DeMarco/DMH-Dual-VCF-Diode-Ladder-Mk2/README.md

# DMH-Dual-VCF-Diode-Ladder-Mk2
Version 2 of my dual Diode Ladder VCF module
