DeMarco/DMH-Dual-VCF-Diode-Ladder-Mk2/Simulations/circuit-20260523-2215.png

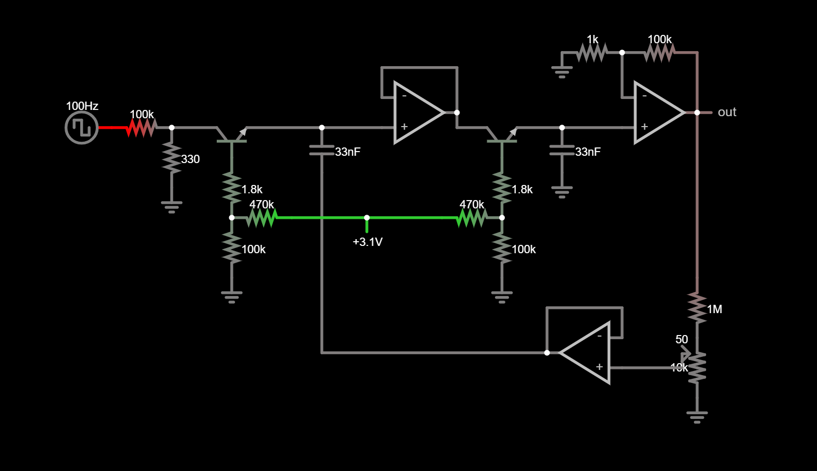
Simulations/circuit-20260523-2215.png
