DeMarco/DMH-Dual-VCF-Diode-Ladder-Mk2/DMH_Dual_VCF_Diode_Ladder_Mk2_PCB_2/DMH_Dual_VCF_Diode_Ladder_Mk2_PCB_2.kicad_pcb

## KiCad design DMH_Dual_VCF_Diode_Ladder_Mk2_PCB_2/DMH_Dual_VCF_Diode_Ladder_Mk2_PCB_2.kicad_pcb (2026-05-23)

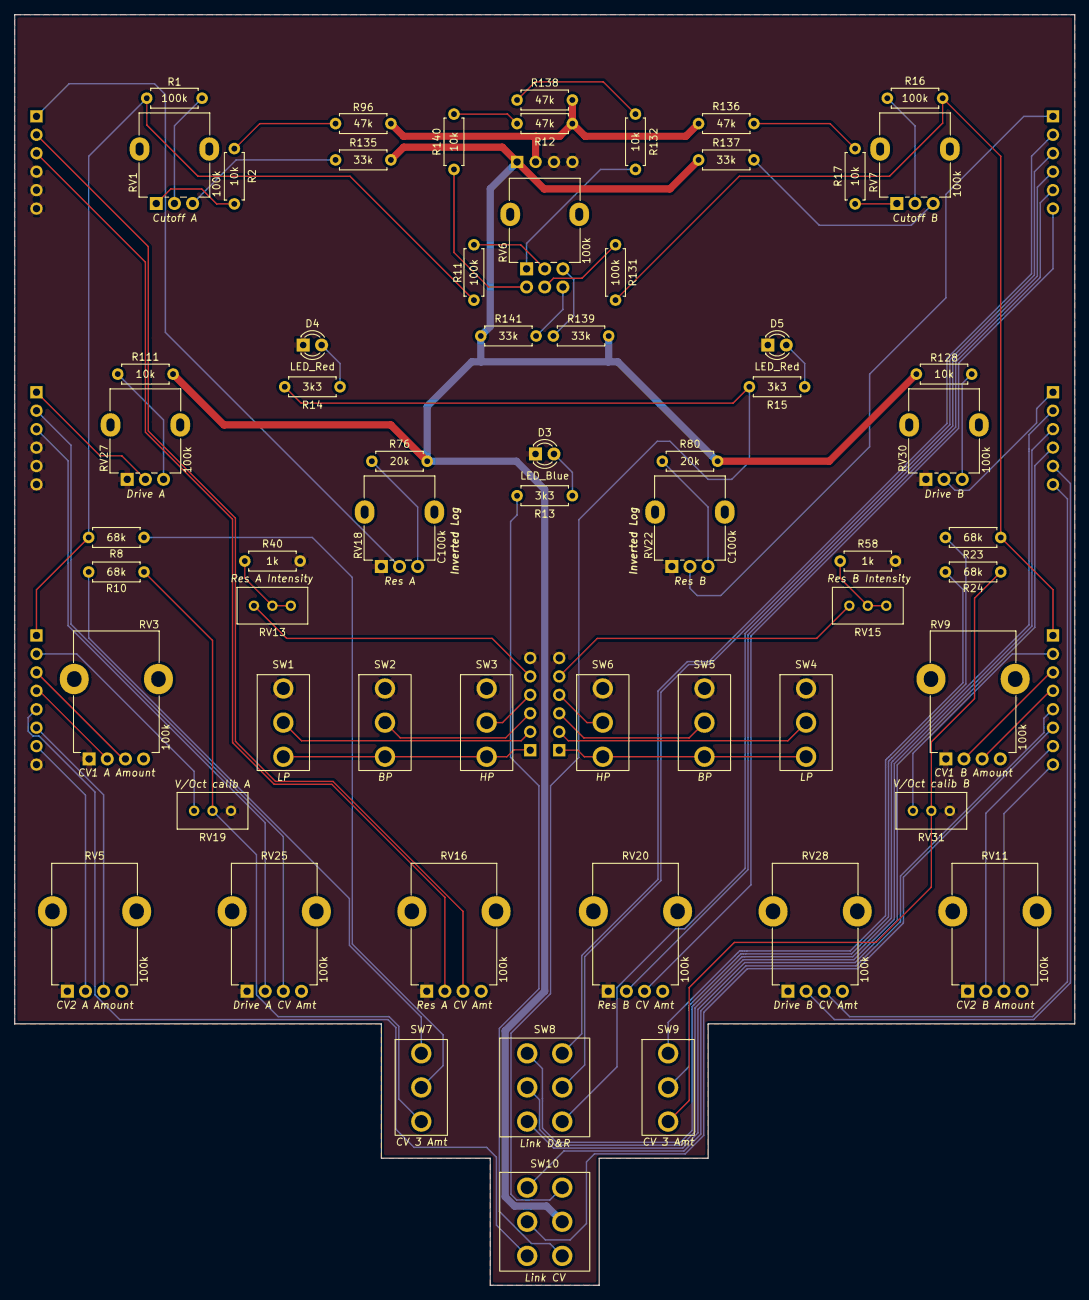
[picture p13: board DMH_Dual_VCF_Diode_Ladder_Mk2_PCB_2.kicad_pcb from above]

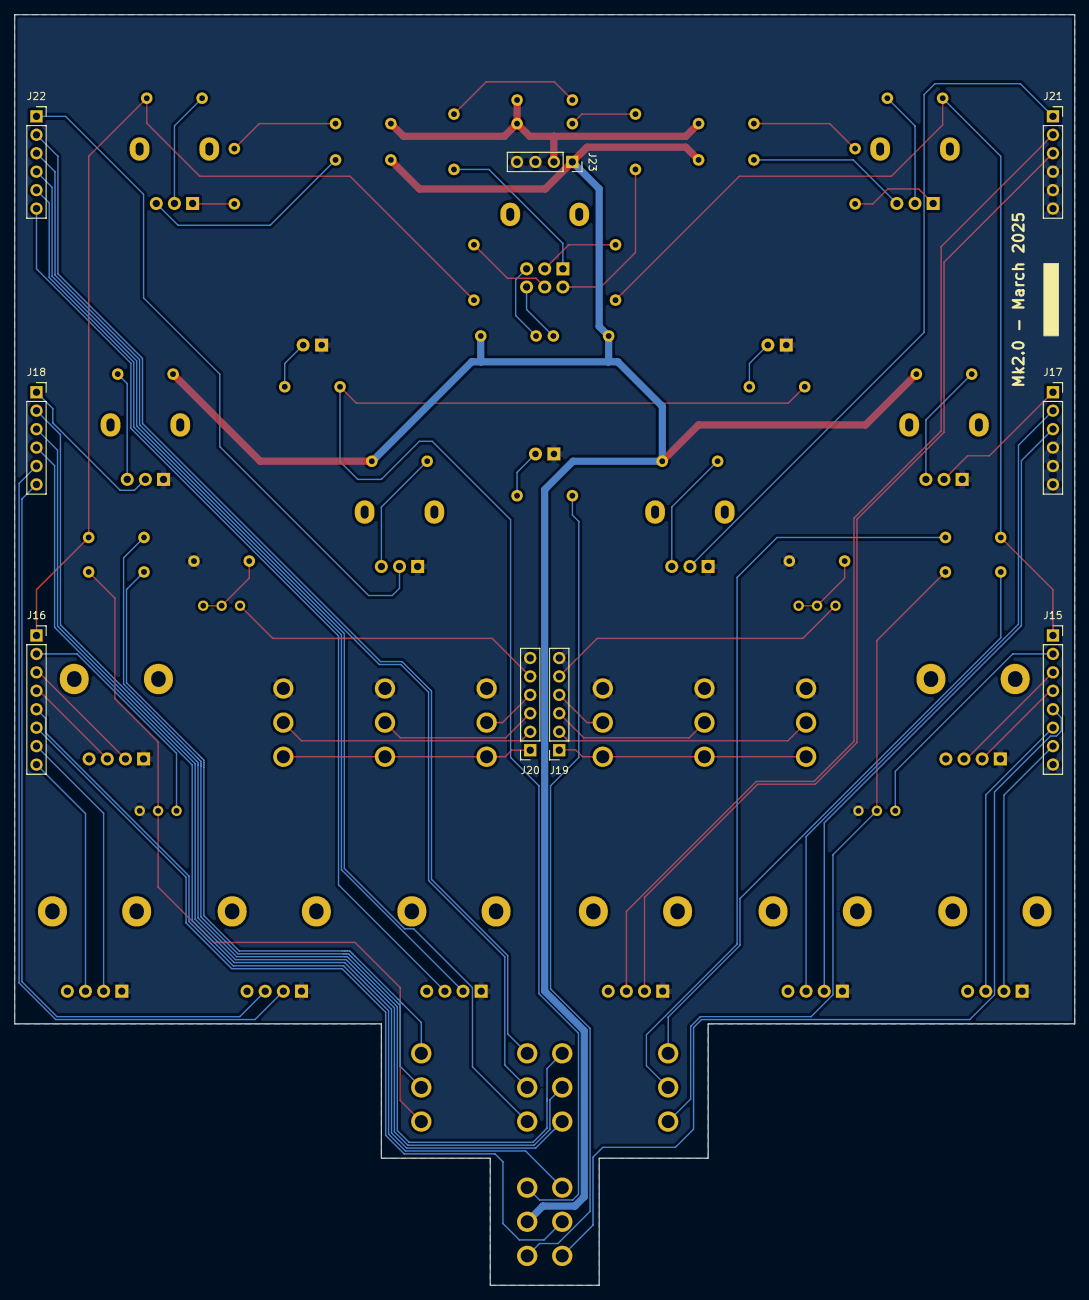
[picture p14: board DMH_Dual_VCF_Diode_Ladder_Mk2_PCB_2.kicad_pcb from below]

Board: 2 copper layers, 146.0 x 175.0 mm, 70 parts (9 on the bottom side), 79 nets.

Parts:
D3: LED_Blue; LED_D3.0mm
D4, D5: LED_Red; LED_D3.0mm
J15, J16: Conn_01x08_PinHeader; PinSocket_1x08_P2.54mm_Vertical
J17, J18, J19, J20, J21, J22: Conn_01x06_PinHeader; PinSocket_1x06_P2.54mm_Vertical
J23: Conn_01x04_PinHeader; PinSocket_1x04_P2.54mm_Vertical
R1, R11, R16, R131: 100k; R_Axial_DIN0207_L6.3mm_D2.5mm_P7.62mm_Horizontal
R2, R17, R111, R128, R132, R140: 10k; R_Axial_DIN0207_L6.3mm_D2.5mm_P7.62mm_Horizontal
R8, R10, R23, R24: 68k; R_Axial_DIN0207_L6.3mm_D2.5mm_P7.62mm_Horizontal
R12, R96, R136, R138: 47k; R_Axial_DIN0207_L6.3mm_D2.5mm_P7.62mm_Horizontal
R13, R14, R15: 3k3; R_Axial_DIN0207_L6.3mm_D2.5mm_P7.62mm_Horizontal
R40, R58: 1k; R_Axial_DIN0207_L6.3mm_D2.5mm_P7.62mm_Horizontal
R76, R80: 20k; R_Axial_DIN0207_L6.3mm_D2.5mm_P7.62mm_Horizontal
R135, R137, R139, R141: 33k; R_Axial_DIN0207_L6.3mm_D2.5mm_P7.62mm_Horizontal
RV1, RV7, RV27, RV30: 100k; Potentiometer_Alpha_RD901F-40-00D_Single_Vertical
RV3, RV5, RV9, RV11, RV16, RV20, RV25, RV28: 100k; Potentiometer_TT_P110KH1
RV6: 100k; Potentiometer_Alpha_RD902F-40-00D_Dual_Vertical
RV13, RV15: 50k; Potentiometer_Bourns_3296W_Vertical
RV18, RV22: C100k; Potentiometer_Alpha_RD901F-40-00D_Single_Vertical
RV19, RV31: 100k; Potentiometer_Bourns_3296W_Vertical
SW1, SW2, SW3, SW4, SW5, SW6: SW_SPDT; Toggle_Switch_TE
SW7, SW9: SW_SPDT_OnOffOn; Toggle_Switch_TE
SW8: SW_DPDT_x2; Toggle_Switch_2_Poles_TE
SW10: SW_DPDT_OnOn; Toggle_Switch_2_Poles_TE

Connections:
+12V: J23.1, R76.2, R80.2, R111.2, R128.2, R135.2, R137.1, R139.2, R141.1, SW10.5 (B)
-12V: J23.2, R12.2, R96.1, R136.1, R138.2
/CV Processing/CV1 A Input: J15.3, RV3.3
/CV Processing/CV1 B Input: J16.4, RV9.3
/CV Processing/CV2 A Input: J15.6, RV5.3
/CV Processing/CV2 B Input: J16.8, RV11.3
/CV Processing/CV A: J15.5, SW10.1 (A)
/CV Processing/CV B: J16.5, SW10.3 (C)
/CV Processing/Link CV Switch: J16.6, SW10.2 (B)
/Drive A/Drive CV: J18.4, SW8.1 (A)
/Drive A/Drive CV Input: J17.2, RV25.3
/Drive B/Drive CV Input: J18.6, RV28.3
/Inputs and Outputs A/Res CV Jack: J21.2, RV16.3
/Inputs and Outputs B/Res CV Jack: J22.6, RV20.3
/Resonance A CV/Res CV: J22.4, SW8.4 (A)
GND: D3.1 (K), D4.1 (K), D5.1 (K), J15.8, J17.4, J17.5, J17.6, J19.6, J20.6, J21.4, J21.5, J21.6, J23.3, J23.4, R40.2, R58.2, RV3.1, RV5.1, RV9.1, RV11.1, RV16.1, RV18.1, RV19.3, RV20.1, RV22.1, RV25.1, RV27.1, RV28.1, RV30.1, RV31.3, SW1.3 (C), SW2.3 (C), SW3.3 (C), SW4.3 (C), SW5.3 (C), SW6.3 (C)
unnamed: D3.2 (A), R13.2
unnamed: D4.2 (A), R14.2
unnamed: D5.2 (A), R15.2
unnamed: J15.1, R1.2, R8.1, R11.2
unnamed: J15.2, RV19.1
unnamed: J15.4, RV3.2
unnamed: J15.7, RV5.2
unnamed: J16.1, R16.2, R23.1, R131.2
unnamed: J16.2, RV31.1
unnamed: J16.3, RV9.2
unnamed: J16.7, RV11.2
unnamed: J17.1, RV27.2
unnamed: J17.3, RV25.2
unnamed: J18.1, RV30.2
unnamed: J18.2, SW8.3 (C)
unnamed: J18.3, SW8.2 (B)
unnamed: J18.5, RV28.2
unnamed: J19.1, SW1.1 (A), SW2.1 (A), SW3.1 (A)
unnamed: J19.2, SW1.2 (B)
unnamed: J19.3, SW2.2 (B)
unnamed: J19.4, SW3.2 (B)
unnamed: J19.5, RV13.1
unnamed: J20.1, SW4.1 (A), SW5.1 (A), SW6.1 (A)
unnamed: J20.2, SW4.2 (B)
unnamed: J20.3, SW5.2 (B)
unnamed: J20.4, SW6.2 (B)
unnamed: J20.5, RV15.1
unnamed: J21.1, RV18.2
unnamed: J21.3, RV16.2
unnamed: J22.1, RV22.2
unnamed: J22.2, SW8.6 (C)
unnamed: J22.3, SW8.5 (B)
unnamed: J22.5, RV20.2
unnamed: R1.1, RV1.2
unnamed: R2.1, RV1.1
unnamed: R2.2, R96.2
unnamed: R11.1, RV6.2
unnamed: R12.1, R140.2
unnamed: R13.1, SW10.4 (A)
unnamed: R14.1, R15.1, SW10.6 (C)
unnamed: R16.1, RV7.2
unnamed: R17.1, RV7.1
unnamed: R40.1, RV13.2, RV13.3
unnamed: R58.1, RV15.2, RV15.3
unnamed: R76.1, RV18.3
unnamed: R80.1, RV22.3
unnamed: R111.1, RV27.3
unnamed: R128.1, RV30.3
unnamed: R131.1, RV6.5
unnamed: R132.1, RV6.1
unnamed: R132.2, R138.1
unnamed: R135.1, RV1.3
unnamed: R17.2, R136.2
unnamed: R137.2, RV7.3
unnamed: R139.1, RV6.3
unnamed: R140.1, RV6.4
unnamed: R141.2, RV6.6
unnamed: R10.2, RV19.2, SW7.1 (A)
unnamed: R8.2, SW7.2 (B)
unnamed: R10.1, SW7.3 (C)
unnamed: R24.2, RV31.2, SW9.1 (A)
unnamed: R23.2, SW9.2 (B)
unnamed: R24.1, SW9.3 (C)
