DeMarco/DMH-Dual-VCF-Diode-Ladder-Mk2/DMH_Dual_VCF_Diode_Ladder_Mk2_PCB_1/DMH_Dual_VCF_Diode_Ladder_Mk2_PCB_1.kicad_pcb

## KiCad design DMH_Dual_VCF_Diode_Ladder_Mk2_PCB_1/DMH_Dual_VCF_Diode_Ladder_Mk2_PCB_1.kicad_pcb (2026-05-23)

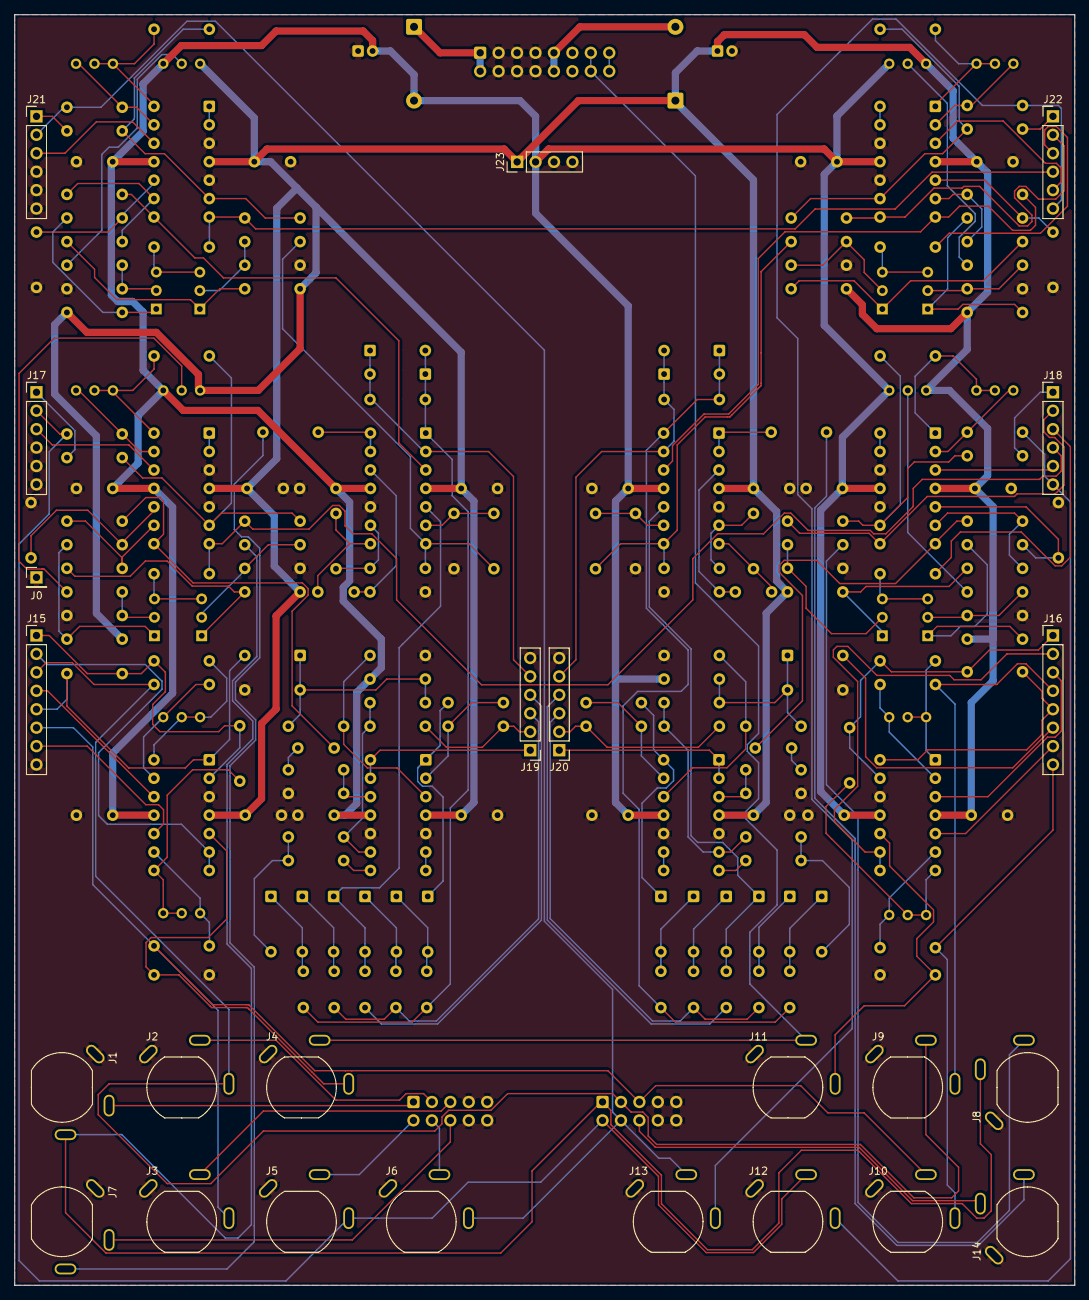
[picture p15: board DMH_Dual_VCF_Diode_Ladder_Mk2_PCB_1.kicad_pcb from above]

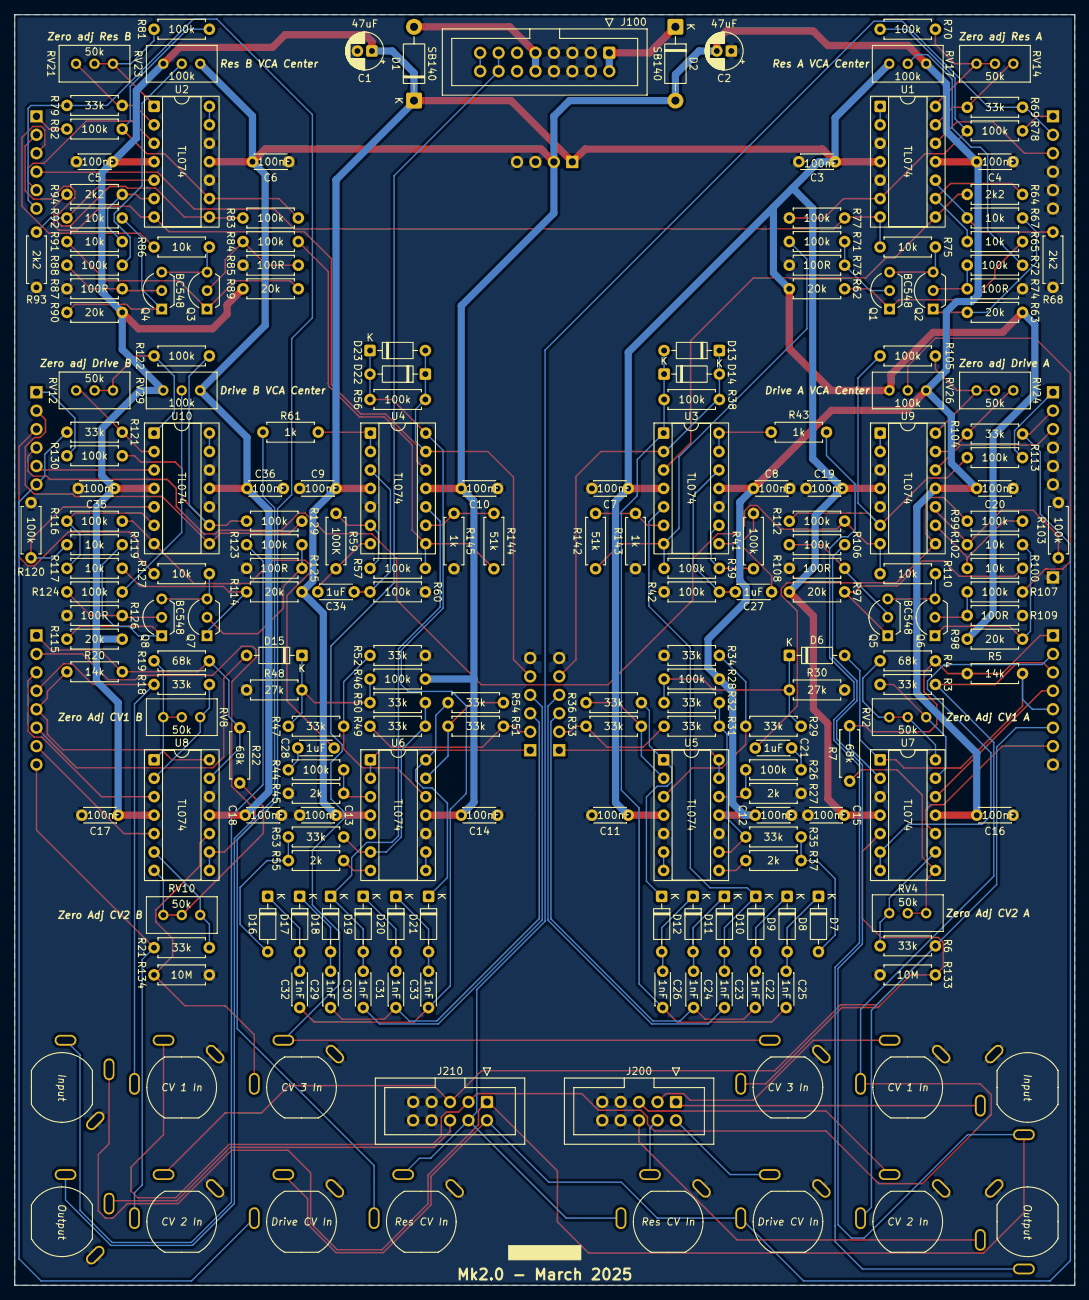
[picture p16: board DMH_Dual_VCF_Diode_Ladder_Mk2_PCB_1.kicad_pcb from below]

Board: 2 copper layers, 146.0 x 175.0 mm, 223 parts (199 on the bottom side), 167 nets.

Parts:
C1, C2: 47uF; CP_Radial_D5.0mm_P2.00mm
C3, C4, C5, C6, C7, C8, C9, C10, C11, C12, C13, C14, C15, C16, C17, C18, C19, C20, C35, C36: 100nF; C_Disc_D4.3mm_W1.9mm_P5.00mm
C21, C27, C28, C34: 1uF; C_Disc_D4.3mm_W1.9mm_P5.00mm
C22, C23, C24, C25, C26, C29, C30, C31, C32, C33: 1nF; C_Disc_D4.3mm_W1.9mm_P5.00mm
D1, D2: SB140; D_DO-41_SOD81_P10.16mm_Horizontal
D6, D7, D8, D9, D10, D11, D12, D13, D14, D15, D16, D17, D18, D19, D20, D21, D22, D23: 1N4148; D_DO-35_SOD27_P7.62mm_Horizontal
J0: Conn_01x01; PinHeader_1x01_P2.54mm_Vertical
J1, J2, J3, J4, J5, J6, J7, J8, J9, J10, J11, J12, J13, J14: TS_Jack_6.35mm_Sw; CUI_MJ-63052A
J15, J16: Conn_01x08_PinHeader; PinHeader_1x08_P2.54mm_Vertical
J17, J18, J19, J20, J21, J22: Conn_01x06_PinHeader; PinHeader_1x06_P2.54mm_Vertical
J23: Conn_01x04_PinHeader; PinHeader_1x04_P2.54mm_Vertical
J100: IDC_02x08; IDC-Header_2x08_P2.54mm_Vertical_Eurorack
J200, J210: IDC_02x05; IDC-Header_2x05_P2.54mm_Vertical_BackBone
Q1, Q2, Q3, Q4, Q5, Q6, Q7, Q8: BC548; TO-92L_Inline_Wide
R3, R6, R18, R21, R29, R31, R32, R33, R34, R35, R36, R47, R49, R50, R51, R52, R53, R54, R69, R79, R104, R121: 33k; R_Axial_DIN0207_L6.3mm_D2.5mm_P7.62mm_Horizontal
R4, R7, R19, R22: 68k; R_Axial_DIN0207_L6.3mm_D2.5mm_P7.62mm_Horizontal
R5, R20: 14k; R_Axial_DIN0207_L6.3mm_D2.5mm_P7.62mm_Horizontal
R26, R28, R38, R39, R41, R42, R44, R46, R56, R57, R60, R70, R71, R72, R77, R78, R81, R82, R83, R84, R88, R99, R103, R105, R106, R107, R112, R113, R116, R120, R122, R123, R124, R129, R130: 100k; R_Axial_DIN0207_L6.3mm_D2.5mm_P7.62mm_Horizontal
R27, R37, R45, R55: 2k; R_Axial_DIN0207_L6.3mm_D2.5mm_P7.62mm_Horizontal
R30, R48: 27k; R_Axial_DIN0207_L6.3mm_D2.5mm_P7.62mm_Horizontal
R43, R61, R143, R145: 1k; R_Axial_DIN0207_L6.3mm_D2.5mm_P7.62mm_Horizontal
R59: 100K; R_Axial_DIN0207_L6.3mm_D2.5mm_P7.62mm_Horizontal
R62, R63, R89, R90, R97, R98, R114, R115: 20k; R_Axial_DIN0207_L6.3mm_D2.5mm_P7.62mm_Horizontal
R64, R68, R93, R94: 2k2; R_Axial_DIN0207_L6.3mm_D2.5mm_P7.62mm_Horizontal
R65, R67, R75, R86, R91, R92, R100, R102, R110, R117, R119, R127: 10k; R_Axial_DIN0207_L6.3mm_D2.5mm_P7.62mm_Horizontal
R73, R74, R85, R87, R108, R109, R125, R126: 100R; R_Axial_DIN0207_L6.3mm_D2.5mm_P7.62mm_Horizontal
R133, R134: 10M; R_Axial_DIN0207_L6.3mm_D2.5mm_P7.62mm_Horizontal
R142, R144: 51k; R_Axial_DIN0207_L6.3mm_D2.5mm_P7.62mm_Horizontal
RV2, RV4, RV8, RV10, RV12, RV14, RV21, RV24: 50k; Potentiometer_Bourns_3296W_Vertical
RV17, RV23, RV26, RV29: 100k; Potentiometer_Bourns_3296W_Vertical
U1, U2, U3, U4, U5, U6, U7, U8, U9, U10: TL074; DIP-14_W7.62mm_Socket

Connections:
+12V: C1.1, C3.1, C5.1, C7.1, C9.1, C11.1, C13.1, C15.1, C17.1, C19.1, C35.1, D1.1 (K), J23.1, R62.2, R63.2, R89.2, R90.2, R97.2, R98.2, R114.2, R115.2, RV17.3, RV23.3, RV26.3, RV29.3, U1.4 (V+), U2.4 (V+), U3.4 (V+), U4.4 (V+), U5.4 (V+), U6.4 (V+), U7.4 (V+), U8.4 (V+), U9.4 (V+), U10.4 (V+)
-12V: C2.2, C4.2, C6.2, C8.2, C10.2, C12.2, C14.2, C16.2, C18.2, C20.2, C36.2, D2.2 (A), J23.2, R28.1, R46.1, RV17.1, RV23.1, RV26.1, RV29.1, U1.11 (V-), U2.11 (V-), U3.11 (V-), U4.11 (V-), U5.11 (V-), U6.11 (V-), U7.11 (V-), U8.11 (V-), U9.11 (V-), U10.11 (V-)
/CV Processing/CV1 A Input: J2.T, J9.TN, J15.3, J210.2, R3.1
/CV Processing/CV1 B Input: J9.T, J16.4, R18.1
/CV Processing/CV2 A Input: J3.T, J10.TN, J15.6, J210.3, R6.1
/CV Processing/CV2 B Input: J10.T, J16.8, R21.1
/CV Processing/CV3 A Input: J4.T, R133.2, U7.5 (+)
/CV Processing/CV3 B Input: J11.T, R134.2, U8.10 (+)
/CV Processing/CV A: D6.2 (A), J15.5, R5.2, U7.1
/CV Processing/CV B: J16.5, R20.2, U8.14
/CV Processing/Link CV Switch: D15.2 (A), J16.6
/Core Circuit A/Input: C21.1, R99.1, U9.8
/Core Circuit A/Output: J7.T, R43.2
/Core Circuit A/Raw Output: R39.1, R71.2, R142.2, U3.7
/Core Circuit A/Res Input: R64.1, U1.8, U3.3 (+)
/Core Circuit B/Input: C28.1, R116.1, U10.7
/Core Circuit B/Output: J14.T, R61.2
/Core Circuit B/Raw Output: R57.1, R84.2, R144.2, U4.8
/Core Circuit B/Res Input: R94.1, U2.7, U4.12 (+)
/Drive A/Drive CV: J18.4, R110.1, R112.2, U9.7
/Drive A/Drive CV Input: J5.T, J12.TN, J17.2, J210.6, R104.1
/Drive A/Input: J1.T, J8.TN, J210.1, R106.2
/Drive B/Drive CV Input: J12.T, J18.6, R121.1
/Drive B/Input: J8.T, R123.2
/Inputs and Outputs A/CV 3 TN: J4.TN, J11.TN, J100.7a, J100.7b
/Inputs and Outputs A/Res CV Jack: J6.T, J13.TN, J21.2, J210.7, R69.1
/Inputs and Outputs B/Res CV Jack: J13.T, J22.6, R79.1
/Power/Bus Gate: J100.8a, J100.8b
/Resonance A CV/Res CV: J22.4, R75.1, R77.2, U1.7
GND: C1.2, C2.1, C3.2, C4.1, C5.2, C6.1, C7.2, C8.1, C9.2, C10.1, C11.2, C12.1, C13.2, C14.1, C15.2, C16.1, C17.2, C18.1, C19.2, C20.1, C35.2, C36.1, J0.1, J1.S, J2.S, J3.S, J4.S, J5.S, J6.S, J7.S, J8.S, J9.S, J10.S, J11.S, J12.S, J13.S, J14.S, J15.8, J17.4, J17.5, J17.6, J19.6, J20.6, J21.4, J21.5, J21.6, J23.3, J23.4, J100.2a, J100.2b, J100.3a, J100.3b, J100.4a, J100.4b, J200.4, J200.5, J200.9, J200.10, J210.4, J210.5, J210.9, J210.10, R27.1, R30.2, R34.1, R42.1, R45.1, R48.2, R52.1, R60.1, R68.2, R73.1, R74.1, R85.1, R87.1, R93.2, R103.2, R108.1, R109.1, R120.2, R125.1, R126.1, R133.1, R134.1, R143.1, R145.1, U1.3 (+), U1.5 (+), U2.10 (+), U2.12 (+), U3.10 (+), U4.5 (+), U5.5 (+), U5.10 (+), U6.5 (+), U6.10 (+), U7.3 (+), U8.12 (+), U9.3 (+), U9.5 (+), U10.10 (+), U10.12 (+)
unnamed: C21.2, R26.1
unnamed: C27.1, R41.2, U3.8
unnamed: C28.2, R44.1
unnamed: C34.1, R59.2, U4.7
unnamed: D1.2 (A), J100.5a, J100.5b
unnamed: D2.1 (K), J100.1a, J100.1b
unnamed: D6.1 (K), R28.2, R29.1, R30.1, R32.1
unnamed: D7.2 (A), R35.2, R37.2
unnamed: C25.1, D7.1 (K), D8.2 (A)
unnamed: C22.2, D8.1 (K), D9.2 (A)
unnamed: C23.2, D9.1 (K), D10.2 (A), U3.5 (+)
unnamed: C24.2, D10.1 (K), D11.2 (A)
unnamed: C26.1, D11.1 (K), D12.2 (A)
unnamed: D12.1 (K), R36.2, U5.1
unnamed: C25.2, C26.2, D13.2 (A), D14.1 (K), R38.1, U3.1
unnamed: D13.1 (K), D14.2 (A), J19.5, R38.2, U3.2 (-)
unnamed: D15.1 (K), R46.2, R47.1, R48.1, R50.1
unnamed: D16.2 (A), R53.2, R55.2
unnamed: C32.1, D16.1 (K), D17.2 (A)
unnamed: C29.2, D17.1 (K), D18.2 (A)
unnamed: C30.2, D18.1 (K), D19.2 (A), U4.10 (+)
unnamed: C31.2, D19.1 (K), D20.2 (A)
unnamed: C33.1, D20.1 (K), D21.2 (A)
unnamed: D21.1 (K), R54.2, U6.14
unnamed: C32.2, C33.2, D22.2 (A), D23.1 (K), R56.1, U4.14
unnamed: D22.1 (K), D23.2 (A), J20.5, R56.2, U4.13 (-)
unnamed: J15.1, R4.2, R5.1, R7.2, U7.2 (-)
unnamed: J15.2, U7.6 (-), U7.7
unnamed: J15.4, U7.12 (+)
unnamed: J15.7, U7.10 (+)
unnamed: J16.1, R19.2, R20.1, R22.2, U8.13 (-)
unnamed: J16.2, U8.8, U8.9 (-)
unnamed: J16.3, U8.3 (+)
unnamed: J16.7, U8.5 (+)
unnamed: J17.1, R113.1
unnamed: J17.3, U9.12 (+)
unnamed: J18.1, R130.1
unnamed: J18.2, R129.2, U10.8
unnamed: J18.3, R127.1
unnamed: J18.5, U10.3 (+)
unnamed: J19.1, U5.13 (-), U5.14
unnamed: J19.2, R31.1, R33.1
unnamed: C22.1, C24.1, J19.3
unnamed: C23.1, J19.4
unnamed: J20.1, U6.1, U6.2 (-)
unnamed: J20.2, R49.1, R51.1
unnamed: C29.1, C31.1, J20.3
unnamed: C30.1, J20.4
unnamed: J21.1, R78.1
unnamed: J21.3, U1.12 (+)
unnamed: J22.1, R82.1
unnamed: J22.2, R83.2, U2.8
unnamed: J22.3, R86.1
unnamed: J22.5, U2.3 (+)
unnamed: J1.TN, J200.1
unnamed: J2.TN, J200.2
unnamed: J3.TN, J200.3
unnamed: J5.TN, J200.6
unnamed: J6.TN, J200.7
unnamed: J7.TN, J200.8
unnamed: J14.TN, J210.8
unnamed: Q1.2 (B), R71.1, R73.2
unnamed: Q1.1 (C), R62.1, R65.2
unnamed: Q1.3 (E), Q2.3 (E), R75.2
unnamed: Q2.2 (B), R72.2, R74.2
unnamed: Q2.1 (C), R63.1, R67.2
unnamed: Q3.2 (B), R84.1, R85.2
unnamed: Q3.1 (C), R89.1, R91.2
unnamed: Q3.3 (E), Q4.3 (E), R86.2
unnamed: Q4.2 (B), R87.2, R88.2
unnamed: Q4.1 (C), R90.1, R92.2
unnamed: Q5.2 (B), R106.1, R108.2
unnamed: Q5.1 (C), R97.1, R100.2
unnamed: Q5.3 (E), Q6.3 (E), R110.2
unnamed: Q6.2 (B), R107.2, R109.2
unnamed: Q6.1 (C), R98.1, R102.2
unnamed: Q7.2 (B), R123.1, R125.2
unnamed: Q7.1 (C), R114.1, R117.2
unnamed: Q7.3 (E), Q8.3 (E), R127.2
unnamed: Q8.2 (B), R124.2, R126.2
unnamed: Q8.1 (C), R115.1, R119.2
unnamed: R4.1, RV2.2, RV2.3, U7.14
unnamed: R7.1, RV4.2, RV4.3, U7.8
unnamed: R19.1, RV8.2, RV8.3, U8.1
unnamed: R22.1, RV10.2, RV10.3, U8.7
unnamed: R37.1, U5.8
unnamed: R55.1, U6.7
unnamed: R70.1, RV14.2, RV14.3, U1.14
unnamed: R72.1, RV17.2
unnamed: R81.1, RV21.2, RV21.3, U2.1
unnamed: R88.1, RV23.2
unnamed: R105.1, RV24.2, RV24.3, U9.14
unnamed: R107.1, RV26.2
unnamed: R122.1, RV12.2, RV12.3, U10.1
unnamed: R124.1, RV29.2
unnamed: U1.1, U1.2 (-)
unnamed: R70.2, R77.1, R78.2, U1.6 (-)
unnamed: R67.1, R68.1, U1.10 (+)
unnamed: R64.2, R65.1, U1.9 (-)
unnamed: R69.2, RV14.1, U1.13 (-)
unnamed: R79.2, RV21.1, U2.2 (-)
unnamed: R92.1, R93.1, U2.5 (+)
unnamed: R91.1, R94.2, U2.6 (-)
unnamed: R81.2, R82.2, R83.1, U2.9 (-)
unnamed: U2.13 (-), U2.14
unnamed: R142.1, R143.2, U3.6 (-)
unnamed: R39.2, R41.1, U3.9 (-)
unnamed: C27.2, R42.2, U3.12 (+)
unnamed: R43.1, U3.13 (-), U3.14
unnamed: C34.2, R60.2, U4.3 (+)
unnamed: R61.1, U4.1, U4.2 (-)
unnamed: R57.2, R59.1, U4.6 (-)
unnamed: R144.1, R145.2, U4.9 (-)
unnamed: R29.2, R34.2, U5.3 (+)
unnamed: R33.2, R36.1, U5.2 (-)
unnamed: U5.6 (-), U5.7
unnamed: R31.2, R32.2, R35.1, U5.9 (-)
unnamed: R26.2, R27.2, U5.12 (+)
unnamed: R44.2, R45.2, U6.3 (+)
unnamed: R49.2, R50.2, R53.1, U6.6 (-)
unnamed: U6.8, U6.9 (-)
unnamed: R47.2, R52.2, U6.12 (+)
unnamed: R51.2, R54.1, U6.13 (-)
unnamed: R6.2, RV4.1, U7.9 (-)
unnamed: R3.2, RV2.1, U7.13 (-)
unnamed: R18.2, RV8.1, U8.2 (-)
unnamed: R21.2, RV10.1, U8.6 (-)
unnamed: U9.1, U9.2 (-)
unnamed: R105.2, R112.1, R113.2, U9.6 (-)
unnamed: R102.1, R103.1, U9.10 (+)
unnamed: R99.2, R100.1, U9.9 (-)
unnamed: R104.2, RV24.1, U9.13 (-)
unnamed: R121.2, RV12.1, U10.2 (-)
unnamed: R119.1, R120.1, U10.5 (+)
unnamed: R116.2, R117.1, U10.6 (-)
unnamed: R122.2, R129.1, R130.2, U10.9 (-)
unnamed: U10.13 (-), U10.14
