DeMarco/DMH-Dual-VCF-Diode-Ladder-Mk2/(commit log)

2025-01-14 Created KiCad projects
    [Bridge.kicad_sch, CV_Processing.kicad_sch, Core_Circuit.kicad_sch, Core_Circuit_A.kicad_sch, Core_Circuit_B.kicad_sch, DMH_Dual_VCF_Diode_Ladder_Mk2_PANEL.kicad_pcb, DMH_Dual_VCF_Diode_Ladder_Mk2_PANEL.kicad_sch, DMH_Dual_VCF_Diode_Ladder_Mk2_PCB_1.kicad_pcb]
2025-01-15 Added CV3 and Drive CV to Panel
    [DMH_Dual_VCF_Diode_Ladder_Mk2_PANEL.kicad_pcb, DMH_Dual_VCF_Diode_Ladder_Mk2_PANEL.kicad_sch]
2025-01-15 Added CV3 and Drive CV to I/O pages
    [CV_Processing.kicad_sch, DMH_Dual_VCF_Diode_Ladder_Mk2_PCB_1.kicad_sch, Inputs_and_Outputs_A.kicad_sch, Inputs_and_Outputs_B.kicad_sch]
2025-01-18 Added board-to-board pins to schematic
    [CV_Processing.kicad_sch, Core_Circuit_A.kicad_sch, Core_Circuit_B.kicad_sch, DMH_Dual_VCF_Diode_Ladder_Mk2_PCB_1.kicad_sch, Inputs_and_Outputs_A.kicad_sch, Inputs_and_Outputs_B.kicad_sch, Resonance_A_CV.kicad_sch, Resonance_B_CV.kicad_sch]
2025-01-19 Created Drive CV circuits
    [Core_Circuit_A.kicad_sch, DMH_Dual_VCF_Diode_Ladder_Mk2_PCB_1.kicad_sch, Drive_A.kicad_sch, Drive_A_CV.kicad_sch, Drive_B.kicad_sch, Resonance_B_CV.kicad_sch]
2025-01-19 Added inter-board pins to all circuits
    [CV_Processing.kicad_sch, Core_Circuit_A.kicad_sch, Core_Circuit_B.kicad_sch, DMH_Dual_VCF_Diode_Ladder_Mk2_PCB_1.kicad_sch, Drive_A.kicad_sch, Drive_B.kicad_sch, Inputs_and_Outputs_A.kicad_sch, Inputs_and_Outputs_B.kicad_sch]
2025-01-20 Connecting main blocks in progress
    [CV_Processing.kicad_sch, Core_Circuit_A.kicad_sch, Core_Circuit_B.kicad_sch, DMH_Dual_VCF_Diode_Ladder_Mk2_PCB_1.kicad_sch, Drive_A.kicad_sch, Drive_B.kicad_sch, Inputs_and_Outputs_A.kicad_sch, Inputs_and_Outputs_B.kicad_sch]
2025-01-20 Connected all hierarchical pins
    [DMH_Dual_VCF_Diode_Ladder_Mk2_PCB_1.kicad_sch]
2025-01-21 Annotating OpAmps in progress
    [Resonance_A_CV.kicad_sch]
2025-01-21 Reannotated OpAmps and cleared errors
    [CV_Processing.kicad_sch, DMH_Dual_VCF_Diode_Ladder_Mk2_PCB_1.kicad_sch, Drive_A.kicad_sch, Drive_B.kicad_sch, Power.kicad_sch, Resonance_A_CV.kicad_sch]
2025-01-22 Set Exclude From Board properties for main PCB
    [CV_Processing.kicad_sch, Core_Circuit_A.kicad_sch, Core_Circuit_B.kicad_sch, Drive_A.kicad_sch, Drive_B.kicad_sch, Inputs_and_Outputs_A.kicad_sch, Inputs_and_Outputs_B.kicad_sch, Power.kicad_sch]
2025-01-22 Corrected pin header footprint assignments
    [CV_Processing.kicad_sch, Core_Circuit_A.kicad_sch, Core_Circuit_B.kicad_sch, Drive_B.kicad_sch, Power.kicad_sch, Resonance_B_CV.kicad_sch]
2025-01-22 Created pots PCB project
    [Bridge.kicad_sch, CV_Processing.kicad_sch, Core_Circuit.kicad_sch, Core_Circuit_A.kicad_sch, Core_Circuit_B.kicad_sch, DMH_Dual_VCF_Diode_Ladder_Mk2_PCB_2.kicad_pcb, DMH_Dual_VCF_Diode_Ladder_Mk2_PCB_2.kicad_sch, Drive_A.kicad_sch]
2025-01-22 Exclude From Board in progress
    [CV_Processing.kicad_sch, Core_Circuit_A.kicad_sch, Core_Circuit_B.kicad_sch, DMH_Dual_VCF_Diode_Ladder_Mk2_PCB_2.kicad_sch, Drive_A.kicad_sch, Inputs_and_Outputs_A.kicad_sch, Inputs_and_Outputs_B.kicad_sch, Power.kicad_sch]
2025-01-22 Complete Exclude From Board on PCB 2
    [CV_Processing.kicad_sch, Core_Circuit_A.kicad_sch, Core_Circuit_B.kicad_sch, Drive_A.kicad_sch, Drive_B.kicad_sch, Power.kicad_sch, Resonance_A_CV.kicad_sch, Resonance_B_CV.kicad_sch]
2025-01-22 Component placement on PCB2 in progress
    [CV_Processing.kicad_sch, DMH_Dual_VCF_Diode_Ladder_Mk2_PCB_2.kicad_pcb]
2025-01-23 pcb 2 routing in progress
    [CV_Processing.kicad_sch, Core_Circuit_B.kicad_sch, DMH_Dual_VCF_Diode_Ladder_Mk2_PCB_2.kicad_pcb, Drive_A.kicad_sch, Drive_B.kicad_sch, Power.kicad_sch, Resonance_A_CV.kicad_sch, Resonance_B_CV.kicad_sch]
2025-01-24 Finished PCB 2
    [DMH_Dual_VCF_Diode_Ladder_Mk2_PCB_2.kicad_pcb, Resonance_B_CV.kicad_sch]
2025-01-25 Replaced Central Cutoff pot with dual port
    [CV_Processing.kicad_sch, DMH_Dual_VCF_Diode_Ladder_Mk2_PCB_2.kicad_pcb]
2025-01-26 PCB1 component placement in progress
    [Core_Circuit_A.kicad_sch, Core_Circuit_B.kicad_sch, DMH_Dual_VCF_Diode_Ladder_Mk2_PCB_1.kicad_pcb, Drive_B.kicad_sch]
2025-02-17 Routed one half
    [DMH_Dual_VCF_Diode_Ladder_Mk2_PCB_1.kicad_pcb]
2025-02-17 Placed components on circuit B
    [DMH_Dual_VCF_Diode_Ladder_Mk2_PCB_1.kicad_pcb]
2025-02-17 Routed circuit B
    [CV_Processing.kicad_sch, DMH_Dual_VCF_Diode_Ladder_Mk2_PCB_1.kicad_pcb, Inputs_and_Outputs_A.kicad_sch, Inputs_and_Outputs_B.kicad_sch]
2025-02-18 Added trim pot functions to silkscreen
    [Core_Circuit_A.kicad_sch, Core_Circuit_B.kicad_sch, DMH_Dual_VCF_Diode_Ladder_Mk2_PCB_1.kicad_pcb, Drive_A.kicad_sch, Drive_B.kicad_sch, Resonance_A_CV.kicad_sch, Resonance_B_CV.kicad_sch]
2025-02-18 Adjusted pin header connections
    [CV_Processing.kicad_sch, Core_Circuit_A.kicad_sch, Core_Circuit_B.kicad_sch, DMH_Dual_VCF_Diode_Ladder_Mk2_PCB_1.kicad_pcb, DMH_Dual_VCF_Diode_Ladder_Mk2_PCB_2.kicad_pcb, Drive_A.kicad_sch, Drive_B.kicad_sch, Resonance_A_CV.kicad_sch]
2025-02-23 Converted to KiCad 9
    [CV_Processing.kicad_sch, Core_Circuit_A.kicad_sch, Core_Circuit_B.kicad_sch, DMH_Dual_VCF_Diode_Ladder_Mk2_PANEL.kicad_pcb, DMH_Dual_VCF_Diode_Ladder_Mk2_PANEL.kicad_sch, DMH_Dual_VCF_Diode_Ladder_Mk2_PCB_1.kicad_pcb, DMH_Dual_VCF_Diode_Ladder_Mk2_PCB_1.kicad_sch, DMH_Dual_VCF_Diode_Ladder_Mk2_PCB_2.kicad_pcb]
2025-02-23 Changed VCA CV summing stage feedback to 100k
    [DMH_Dual_VCF_Diode_Ladder_Mk2_PCB_1.kicad_pcb, Drive_A.kicad_sch, Drive_B.kicad_sch, Resonance_A_CV.kicad_sch, Resonance_B_CV.kicad_sch]
2025-03-01 Adding buffered input to CV3 - in progress
    [CV_Processing.kicad_sch, DMH_Dual_VCF_Diode_Ladder_Mk2_PCB_1.kicad_pcb, Drive_A.kicad_sch, Drive_B.kicad_sch, Power.kicad_sch, Resonance_A_CV.kicad_sch, Resonance_B_CV.kicad_sch]
2025-03-01 Added buffering to each CV 3 input separately
    [CV_Processing.kicad_sch, DMH_Dual_VCF_Diode_Ladder_Mk2_PCB_1.kicad_pcb, DMH_Dual_VCF_Diode_Ladder_Mk2_PCB_2.kicad_pcb, Drive_A.kicad_sch, Drive_B.kicad_sch, Power.kicad_sch, Resonance_A_CV.kicad_sch, Resonance_B_CV.kicad_sch]
2025-03-01 Added buffer 10M resistors to PCB 1
    [CV_Processing.kicad_sch, DMH_Dual_VCF_Diode_Ladder_Mk2_PCB_1.kicad_pcb]
2025-03-02 validation ongoing
    [CV_Processing.kicad_sch, Core_Circuit_A.kicad_sch, Resonance_A_CV.kicad_sch]
2025-03-03 Updated schematic during validation
    - Changed Resonance B VCA gain resistors to 2k2
    - Added range limiting resistors to all Cutoff pots
    - Moved 48x gain to non-inverting opamp stage in Core Circuit to allow for Resonance voltage control.
    [CV_Processing.kicad_sch, Core_Circuit_A.kicad_sch, Core_Circuit_B.kicad_sch, Drive_A.kicad_sch, Resonance_B_CV.kicad_sch]
2025-03-08 Updated various resistor values
    ... and deleted all VCAs output 1k resistors
    [Core_Circuit_A.kicad_sch, Core_Circuit_B.kicad_sch, Drive_A.kicad_sch, Drive_B.kicad_sch, Resonance_A_CV.kicad_sch, Resonance_B_CV.kicad_sch]
2025-03-09 Corrected polarization of dual pot in PCB 1 sch
    [CV_Processing.kicad_sch]
2025-03-12 Adapted CV3 A Input for V/Oct
    Now need to repeat it for CV3 B
    [CV_Processing.kicad_sch]
2025-03-14 Added V/oct calib to CV3 B
    And changed output inverter stage resistors back to 100k
    [CV_Processing.kicad_sch, Core_Circuit_A.kicad_sch, Core_Circuit_B.kicad_sch]
2025-03-15 Moved Res Int and CV3 V/Oct trims to front panel
    [Core_Circuit_A.kicad_sch, Core_Circuit_B.kicad_sch, DMH_Dual_VCF_Diode_Ladder_Mk2_PANEL.kicad_pcb, DMH_Dual_VCF_Diode_Ladder_Mk2_PANEL.kicad_sch]
2025-03-15 Synchronized changes from PCB 1 to PCB 2 schematic
    [CV_Processing.kicad_sch, Core_Circuit_A.kicad_sch, Core_Circuit_B.kicad_sch, Drive_A.kicad_sch, Drive_B.kicad_sch, Inputs_and_Outputs_A.kicad_sch, Inputs_and_Outputs_B.kicad_sch, Power.kicad_sch]
2025-03-15 Updated PCB 2 with validated features
    [CV_Processing.kicad_sch, Core_Circuit_A.kicad_sch, DMH_Dual_VCF_Diode_Ladder_Mk2_PCB_2.kicad_pcb]
2025-03-15 Finished Mk2.0
    [CV_Processing.kicad_sch, Core_Circuit_A.kicad_sch, Core_Circuit_B.kicad_sch, DMH_Dual_VCF_Diode_Ladder_Mk2_PANEL.kicad_pcb, DMH_Dual_VCF_Diode_Ladder_Mk2_PCB_1.kicad_pcb, DMH_Dual_VCF_Diode_Ladder_Mk2_PCB_2.kicad_pcb, Power.kicad_sch]
2025-03-15 Generated Gerbers
    [DMH_Dual_VCF_Diode_Ladder_Mk2_PANEL-B_Cu.gbl, DMH_Dual_VCF_Diode_Ladder_Mk2_PANEL-B_Mask.gbs, DMH_Dual_VCF_Diode_Ladder_Mk2_PANEL-B_Paste.gbp, DMH_Dual_VCF_Diode_Ladder_Mk2_PANEL-B_Silkscreen.gbo, DMH_Dual_VCF_Diode_Ladder_Mk2_PANEL-Edge_Cuts.gm1, DMH_Dual_VCF_Diode_Ladder_Mk2_PANEL-F_Cu.gtl, DMH_Dual_VCF_Diode_Ladder_Mk2_PANEL-F_Mask.gts, DMH_Dual_VCF_Diode_Ladder_Mk2_PANEL-F_Paste.gtp]
2025-03-17 Generated BoM
    [DMH_Dual_VCF_Diode_Ladder_PCB_Mk2_BoM.csv]
2025-03-17 Regenerated BoM
    [DMH_Dual_VCF_Diode_Ladder_PCB_Mk2_BoM.csv]
2025-03-24 Mistakes found during assembly
    [Core_Circuit_A.kicad_sch, DMH_Dual_VCF_Diode_Ladder_Mk2_PCB_2.kicad_pcb, Drive_A.kicad_sch, Drive_B.kicad_sch]
2025-05-03 Changed Resonance pots to Taper C type
    [DMH_Dual_VCF_Diode_Ladder_Mk2_PCB_1.kicad_pcb, DMH_Dual_VCF_Diode_Ladder_Mk2_PCB_2.kicad_pcb, Resonance_A_CV.kicad_sch, Resonance_B_CV.kicad_sch]
2025-05-07 Exported BoM
    [CV_Processing.kicad_sch, DMH_Dual_VCF_Diode_Ladder_PCB_Mk2_BoM.csv]
2025-10-03 Updated to Kicad 9
2025-10-08 Updated Kicad 9
2025-11-30 KiCad 9
2026-01-31 KiCad 9.0.7 + centralized library
    [DMH_Dual_VCF_Diode_Ladder_Mk2_PANEL.kicad_pcb, DMH_Dual_VCF_Diode_Ladder_Mk2_PANEL.kicad_sch, DMH_Dual_VCF_Diode_Ladder_Mk2_PCB_1.kicad_pcb, DMH_Dual_VCF_Diode_Ladder_Mk2_PCB_2.kicad_pcb, Drive_A.kicad_sch, Drive_B.kicad_sch, Power.kicad_sch, Resonance_A_CV.kicad_sch]
2026-04-03 Create VCF Schematics.pdf
2026-04-03 Re-exported Gerbers
    [CV_Processing.kicad_sch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]
2026-04-03 Moved zipped Gerbers to root folder
2026-04-03 Renamed schematics PDF
2026-05-23 KiCad 10
    [CV_Processing.kicad_sch, Core_Circuit_A.kicad_sch, Core_Circuit_B.kicad_sch, DMH_Dual_VCF_Diode_Ladder_Mk2_PANEL.kicad_pcb, DMH_Dual_VCF_Diode_Ladder_Mk2_PANEL.kicad_sch, DMH_Dual_VCF_Diode_Ladder_Mk2_PCB_1.kicad_pcb, DMH_Dual_VCF_Diode_Ladder_Mk2_PCB_1.kicad_sch, DMH_Dual_VCF_Diode_Ladder_Mk2_PCB_2.kicad_pcb]
